cadenhillis/nixie-tube-clock/README.md

# nixie-tube-clock

custom high-voltage boost power supply and nessesary drivers to control IN-12A and IN13 nixies with an adafruit itsybitsy nRF32
