cadenhillis/nixie-tube-clock/nixie-tube-clock-hw/bargraph.jpg

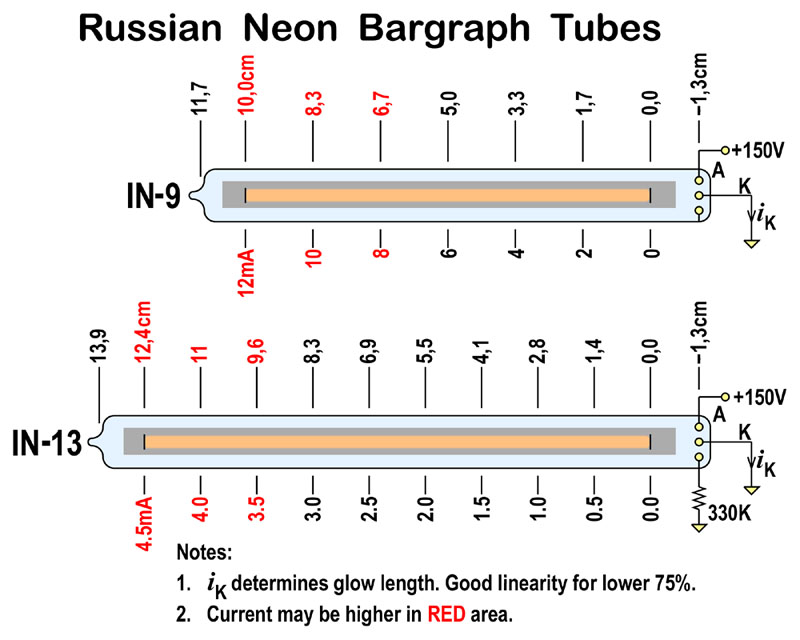
nixie-tube-clock-hw/bargraph.jpg
