cadenhillis/nixie-tube-clock/nixie-tube-clock-hw/fab/nixie-tube-clock digikey.xlsx

nixie-tube-clock
Qty | Reference(s) | P/n
1 | C1 | 63YXJ47M6.3X11
1 | C2 | CL21A225KAFNNNG
1 | C3 | 08053C104KAT2A
1 | C4 | CL21B471KCANNNC
4 | C5, C6, C7, C8 | UPJ2E4R7MPD1TD
1 | C9 | C0805C103J5RAC7800
1 | C10 | CL21B105KAFNNNE
6 | C11, C12, C23, C24, C25, C26 | CL21A106KAYNNNG
2 | C13, C14 | 35ML10MEFCT54X7
8 | C15, C16, C17, C18, C19, C20, C21, C22 | CL21B104KBCNNNC
1 | D1 | SK3200B-LTP
1 | D2 | FDLL4148-D87Z
1 | D3 | BZV55-C3V3,115
2 | D4, D8 | LO R976-PS-1
2 | D5, D6 | NTE30055
1 | D7 | LS R976-NR-1
4 |  | HPH1-A-12-UA
1 | J1 | PJ-036AH-SMT-TR
4 | J2, J3, J4, J5 | LPPB121NFSC-RC
1 | L1 | PM2110-102K-RC
1 | Q1 | FQD16N25CTM
1 | Q2 | PMBT3906,235
44 | Q3, Q4, Q5, Q6, Q7, Q8, Q9, Q10, Q11, Q12, Q13, Q14, Q15, Q16, Q17, Q18, Q19, Q20, Q21, Q22, Q23, Q24, Q25, Q26, Q27, Q28, Q29, Q30, Q31, Q32, Q33, Q34, Q35, Q36, Q37, Q38, Q39, Q40, Q41, Q42, Q43, Q44, Q45, Q46 | MMSTA42-7-F
4 | Q47, Q48, Q49, Q50 | FZT857TA
1 | R1 | ERJ-6DQJR30V
1 | R2 | RNCF0805DTE240R
1 | R3 | RC0805JR-071ML
1 | R4 | KTR10EZPF3004
1 | R5
1 | R6 | RNCP0805FTD20K0
1 | R7 | RC0805FR-071K69L
1 | R8 | RNCP0805FTD24K9
3 | R9, R11, R32 | RNCP0805FTD10K0
6 | R10, R27, R28, R29, R30, R31 | CRG0805F1K2
13 | R12, R13, R14, R15, R16, R17, R18, R19, R20, R21, R22, R23, R24 | RC0805JR-070RL
2 | R25, R26 | CRGCQ0805F220R
40 | R33, R34, R35, R37, R38, R39, R40, R41, R42, R43, R44, R45, R46, R48, R49, R50, R51, R52, R53, R54, R55, R56, R57, R59, R60, R61, R62, R63, R64, R65, R66, R67, R68, R70, R71, R72, R73, R74, R75, R76 | CRGCQ0805F22K
4 | R36, R47, R58, R69 | HRG3216P-2202-D-T1
4 | R77, R81, R85, R89 | CRGCQ0805J330R
4 | R78, R82, R86, R90 | CRG0805F4K7
4 | R79, R83, R87, R91 | ERJ-P6WF3303V
4 | R80, R84, R88, R92 | CRGCQ0805F560R
1 | TH1 | NCP21XV103J03RA
1 | U1 | MC34063AD
1 | U2 | AS321KTR-G1
1 | U4 | NCP1117IDT50T4G
8 | U5, U6, U7, U8, U9, U10, U11, U12 | 74HC594D,118
1 | PS1 | VEL24US120-US-JA
2 | Itsy bitsy sockets | CES-114-01-T-S
