cadenhillis/nixie-tube-clock/nixie-tube-clock-hw/nixie_daughter/nixie_daughter.step

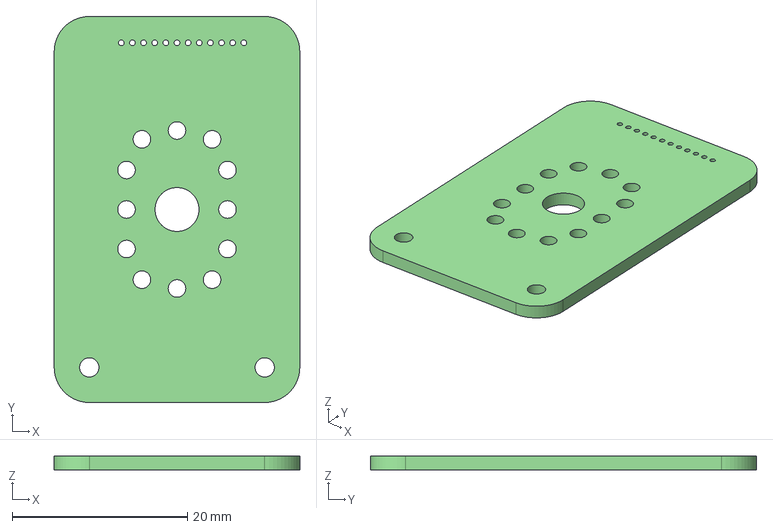
[picture p2: CAD file, 2022-02-12]
nixie-tube-clock-hw/nixie_daughter/nixie_daughter.step
28.0 x 44.0 x 1.60 mm
