cadenhillis/nixie-tube-clock/nixie-tube-clock-hw/parts/front_panel.dxf

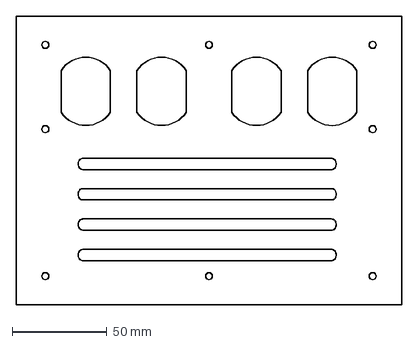
[picture p3: CAD file, 2022-02-14]
nixie-tube-clock-hw/parts/front_panel.dxf
203.2 x 152.4 mm
