cadenhillis/nixie-tube-clock/nixie-tube-clock-hw/parts/in-13_clamp.step

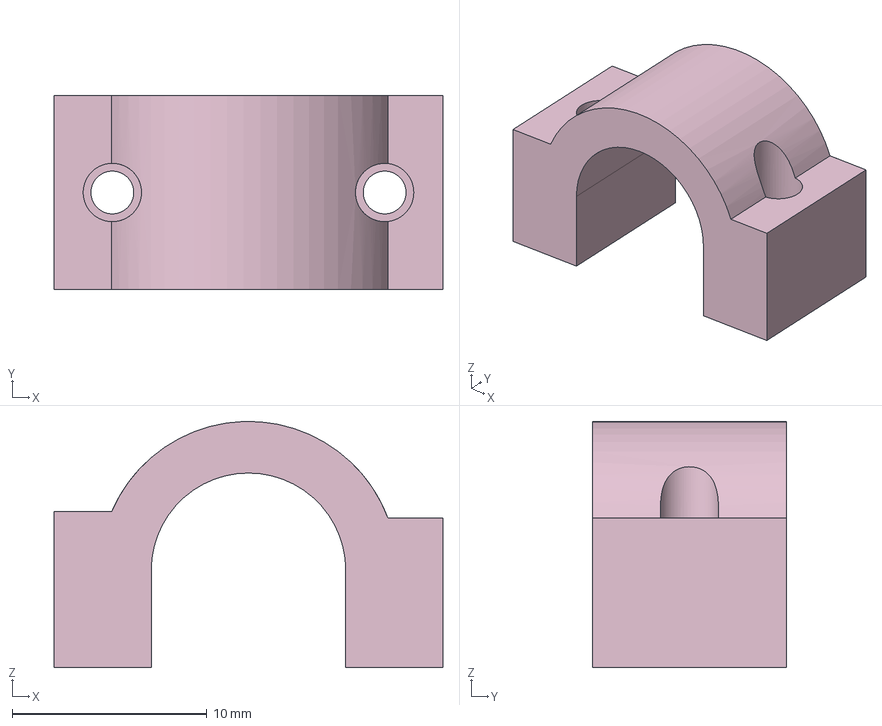
[picture p5: CAD file, 2022-02-14]
nixie-tube-clock-hw/parts/in-13_clamp.step
20.0 x 10.0 x 12.7 mm
