cadenhillis/nixie-tube-clock/(list of files, cad)

Other CAD files:
nixie-tube-clock-hw/parts/in-13_clamp.FCStd
