cadenhillis/nixie-tube-clock/nixie-tube-clock-hw/nixie-tube-clock.kicad_pcb

## KiCad design nixie-tube-clock-hw/nixie-tube-clock.kicad_pcb (2022-02-12)

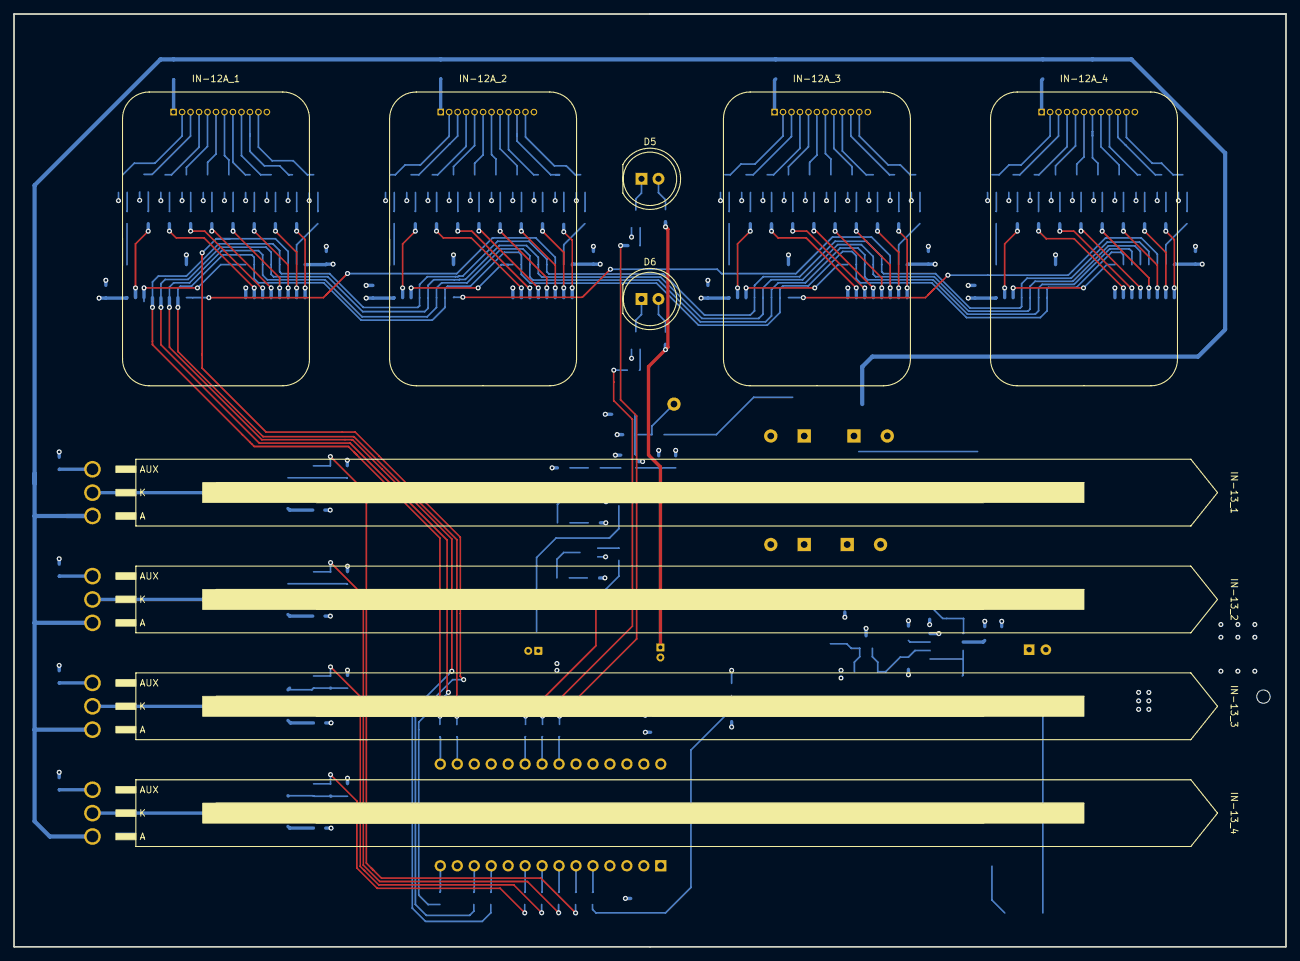
[picture p6: board nixie-tube-clock.kicad_pcb from above]

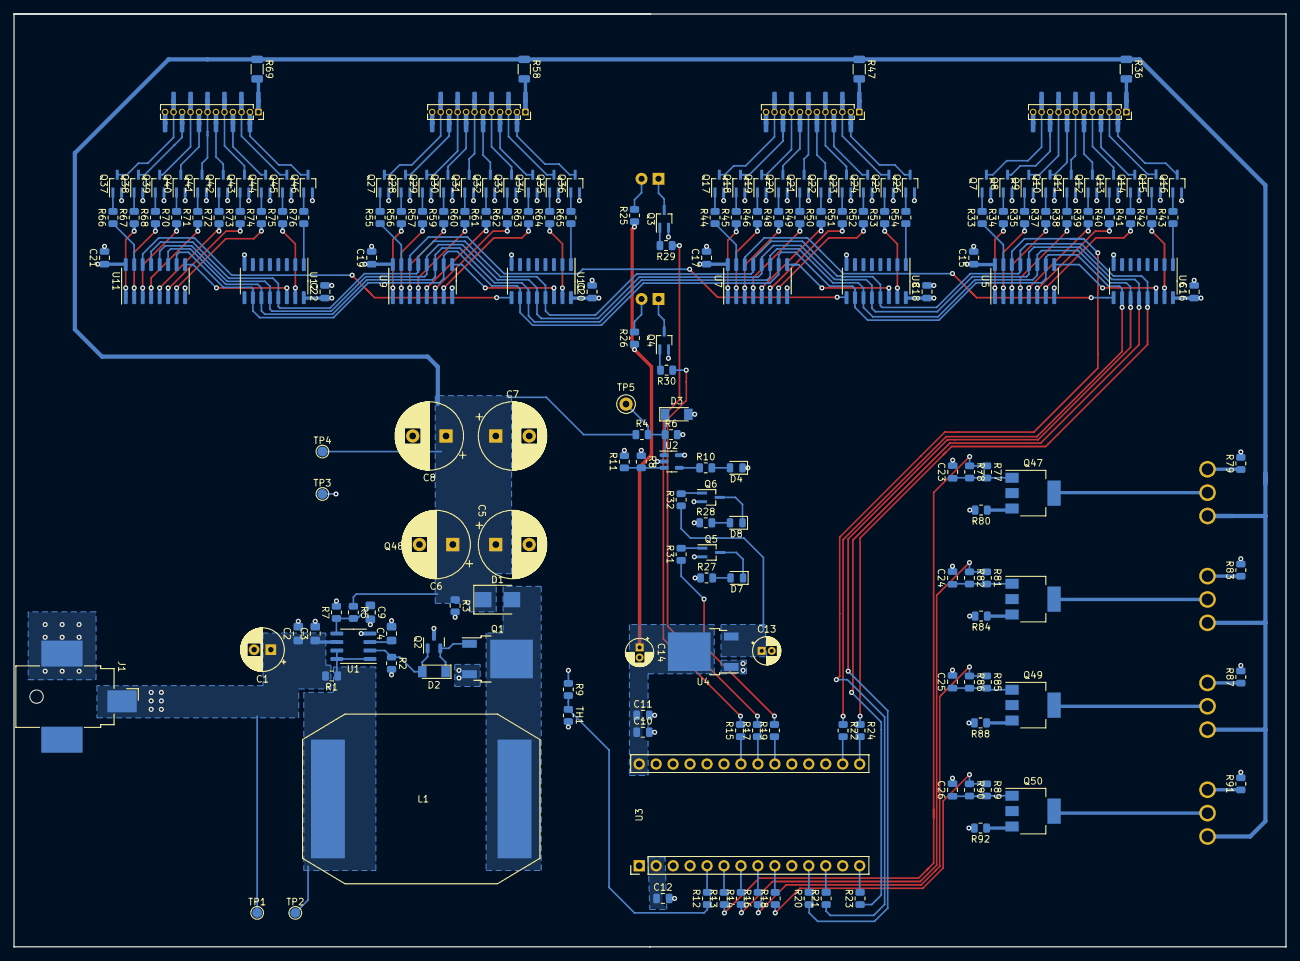
[picture p7: board nixie-tube-clock.kicad_pcb from below]

Board: 4 copper layers, 190.5 x 139.7 mm, 204 parts (194 on the bottom side), 200 nets.

Parts:
C1: 47uF; CP_Radial_D6.3mm_P2.50mm
C2: 2.2uF; C_0805_2012Metric_Pad1.18x1.45mm_HandSolder
C3: 0.1uF; C_0805_2012Metric_Pad1.18x1.45mm_HandSolder
C4: 470pF; C_0805_2012Metric_Pad1.18x1.45mm_HandSolder
C5, C6, C7, C8: 4.7uF; CP_Radial_D10.0mm_P5.00mm
C9: 10nF; C_0805_2012Metric_Pad1.18x1.45mm_HandSolder
C10: 1uF; C_0805_2012Metric
C11, C12, C23, C24, C25, C26: 10uF; C_0805_2012Metric
C13, C14: 10uF; CP_Radial_D4.0mm_P1.50mm
C15, C16, C17, C18, C19, C20, C21, C22: 0.1uF; C_0805_2012Metric
D1: SK3200B-LTP; D_SMB
D2: FDLL4148-D87Z; D_MiniMELF
D3: BZV55-C3V3,115; D_MiniMELF
D4, D8: ORANGE; D_0805_2012Metric
D5, D6: ORANGE; LED_D8.0mm
D7: RED; D_0805_2012Metric
IN-12A_1, IN-12A_2, IN-12A_3, IN-12A_4: IN-12A DAUGHTER; nixie_daughter
IN-13_1, IN-13_2, IN-13_3, IN-13_4: IN13; IN-13
J1: PJ-036AH-SMT-TR; BarrelJack_CUI_PJ-036AH-SMT_Horizontal
L1: 1mH; PM2120
Q1: FQD16N25CTM; TO-252-2
Q2: PMBT3906,235; SOT-23
Q3, Q4, Q5, Q6, Q7, Q8, Q9, Q10, Q11, Q12, Q13, Q14, Q15, Q16, Q17, Q18, Q19, Q20, Q21, Q22, Q23, Q24, Q25, Q26, Q27, Q28, Q29, Q30, Q31, Q32, Q33, Q34, Q35, Q36, Q37, Q38, Q39, Q40, Q41, Q42, Q43, Q44, Q45, Q46: MMSTA42-7-F; SOT-323_SC-70_Handsoldering
Q47, Q48, Q49, Q50: FZT857TA; SOT-223-3_TabPin2
R1: 300mR; R_0805_2012Metric
R2: 240; R_0805_2012Metric
R3: 1M; R_0805_2012Metric
R4: 3Meg; R_0805_2012Metric
R5: 200k; R_0805_2012Metric
R6: 20k; R_0805_2012Metric
R7: 1.68k; R_0805_2012Metric
R8: 25k; R_0805_2012Metric
R9, R11: 10k; R_0805_2012Metric
R10, R27, R28: 1.2k; R_0805_2012Metric
R12, R13, R14, R15, R16, R17, R18, R19, R20, R21, R22, R23, R24: 0; R_0805_2012Metric
R25, R26: 220; R_0805_2012Metric
R29, R30, R31: 1.2K; R_0805_2012Metric
R32: 10K; R_0805_2012Metric
R33, R34, R35, R37, R38, R39, R40, R41, R42, R43, R44, R45, R46, R48, R49, R50, R51, R52, R53, R54, R55, R56, R57, R59, R60, R61, R62, R63, R64, R65, R66, R67, R68, R70, R71, R72, R73, R74, R75, R76: 22k; R_0805_2012Metric
R36, R47, R58, R69: R_US; R_1206_3216Metric
R77, R81, R85, R89: 330; R_0805_2012Metric
R78, R82, R86, R90: 4.7k; R_0805_2012Metric
R79, R83, R87, R91: 330k; R_0805_2012Metric
R80, R84, R88, R92: 560; R_0805_2012Metric
TH1: 10k; R_0805_2012Metric
TP1, TP2, TP3, TP4: TestPoint; TestPoint_Pad_D1.5mm
TP5: TestPoint; TestPoint_Keystone_5000-5004_Miniature
U1: MC34063AD; SOIC-8_3.9x4.9mm_P1.27mm
U2: AS321KTR-G1; SOT-23-5
U3: ItsyBitsy_M0_Express; ItsyBitsy
U4: NCP1117IDT50T4G; TO-252-2
U5, U6, U7, U8, U9, U10, U11, U12: 74HC594D,118; SOIC-16_3.9x9.9mm_P1.27mm

Connections:
+3V3: C12.1, C15.1, C16.1, C17.1, C18.1, C19.1, C20.1, C21.1, C22.1, R8.1, R9.1, R27.1, R28.1, U2.5 (V+), U3.2 (3V3), U5.16 (VCC), U6.16 (VCC), U7.16 (VCC), U8.16 (VCC), U9.16 (VCC), U10.16 (VCC), U11.16 (VCC), U12.16 (VCC)
+5V: C10.1, C11.1, C14.1, R25.1, R26.1, U3.28 (BAT), U4.2 (VO)
+12V: C1.1, C2.1, C3.1, C13.1, J1.1, R1.2, R32.1, TP1.1, U1.6 (Vin), U4.3 (VI)
/150V_VA/1v_LED: D3.1 (K), R4.2, R6.1, TP5.1, U2.1 (+)
/COLON_1: R15.2, R29.1
/COLON_2: R17.2, R30.1
/D1/B0: R43.1, U6.1 (Q1)
/D1/B1: R33.1, U5.15 (Q0)
/D1/B2: R34.1, U5.1 (Q1)
/D1/B3: R35.1, U5.2 (Q2)
/D1/B4: R37.1, U5.3 (Q3)
/D1/B5: R38.1, U5.4 (Q4)
/D1/B6: R39.1, U5.5 (Q5)
/D1/B7: R40.1, U5.6 (Q6)
/D1/B8: R41.1, U5.7 (Q7)
/D1/B9: R42.1, U6.15 (Q0)
/D1/DOUT: U6.9 (Q7S), U7.14 (DS)
/D1/K0: IN-12A_1.2 (K_0), Q16.3 (C)
/D1/K1: IN-12A_1.11 (K_1), Q7.3 (C)
/D1/K2: IN-12A_1.10 (K_2), Q8.3 (C)
/D1/K3: IN-12A_1.9 (K_3), Q9.3 (C)
/D1/K4: IN-12A_1.8 (K_4), Q10.3 (C)
/D1/K5: IN-12A_1.7 (K_5), Q11.3 (C)
/D1/K6: IN-12A_1.6 (K_6), Q12.3 (C)
/D1/K7: IN-12A_1.5 (K_7), Q13.3 (C)
/D1/K8: IN-12A_1.4 (K_8), Q14.3 (C)
/D1/K9: IN-12A_1.3 (K_9), Q15.3 (C)
/D2/B0: R54.1, U8.1 (Q1)
/D2/B1: R44.1, U7.15 (Q0)
/D2/B2: R45.1, U7.1 (Q1)
/D2/B3: R46.1, U7.2 (Q2)
/D2/B4: R48.1, U7.3 (Q3)
/D2/B5: R49.1, U7.4 (Q4)
/D2/B6: R50.1, U7.5 (Q5)
/D2/B7: R51.1, U7.6 (Q6)
/D2/B8: R52.1, U7.7 (Q7)
/D2/B9: R53.1, U8.15 (Q0)
/D2/DOUT: U8.9 (Q7S), U9.14 (DS)
/D2/K0: IN-12A_2.2 (K_0), Q26.3 (C)
/D2/K1: IN-12A_2.11 (K_1), Q17.3 (C)
/D2/K2: IN-12A_2.10 (K_2), Q18.3 (C)
/D2/K3: IN-12A_2.9 (K_3), Q19.3 (C)
/D2/K4: IN-12A_2.8 (K_4), Q20.3 (C)
/D2/K5: IN-12A_2.7 (K_5), Q21.3 (C)
/D2/K6: IN-12A_2.6 (K_6), Q22.3 (C)
/D2/K7: IN-12A_2.5 (K_7), Q23.3 (C)
/D2/K8: IN-12A_2.4 (K_8), Q24.3 (C)
/D2/K9: IN-12A_2.3 (K_9), Q25.3 (C)
/D3/B0: R65.1, U10.1 (Q1)
/D3/B1: R55.1, U9.15 (Q0)
/D3/B2: R56.1, U9.1 (Q1)
/D3/B3: R57.1, U9.2 (Q2)
/D3/B4: R59.1, U9.3 (Q3)
/D3/B5: R60.1, U9.4 (Q4)
/D3/B6: R61.1, U9.5 (Q5)
/D3/B7: R62.1, U9.6 (Q6)
/D3/B8: R63.1, U9.7 (Q7)
/D3/B9: R64.1, U10.15 (Q0)
/D3/DOUT: U10.9 (Q7S), U11.14 (DS)
/D3/K0: IN-12A_3.2 (K_0), Q36.3 (C)
/D3/K1: IN-12A_3.11 (K_1), Q27.3 (C)
/D3/K2: IN-12A_3.10 (K_2), Q28.3 (C)
/D3/K3: IN-12A_3.9 (K_3), Q29.3 (C)
/D3/K4: IN-12A_3.8 (K_4), Q30.3 (C)
/D3/K5: IN-12A_3.7 (K_5), Q31.3 (C)
/D3/K6: IN-12A_3.6 (K_6), Q32.3 (C)
/D3/K7: IN-12A_3.5 (K_7), Q33.3 (C)
/D3/K8: IN-12A_3.4 (K_8), Q34.3 (C)
/D3/K9: IN-12A_3.3 (K_9), Q35.3 (C)
/D4/B0: R76.1, U12.1 (Q1)
/D4/B1: R66.1, U11.15 (Q0)
/D4/B2: R67.1, U11.1 (Q1)
/D4/B3: R68.1, U11.2 (Q2)
/D4/B4: R70.1, U11.3 (Q3)
/D4/B5: R71.1, U11.4 (Q4)
/D4/B6: R72.1, U11.5 (Q5)
/D4/B7: R73.1, U11.6 (Q6)
/D4/B8: R74.1, U11.7 (Q7)
/D4/B9: R75.1, U12.15 (Q0)
/D4/K0: IN-12A_4.2 (K_0), Q46.3 (C)
/D4/K1: IN-12A_4.11 (K_1), Q37.3 (C)
/D4/K2: IN-12A_4.10 (K_2), Q38.3 (C)
/D4/K3: IN-12A_4.9 (K_3), Q39.3 (C)
/D4/K4: IN-12A_4.8 (K_4), Q40.3 (C)
/D4/K5: IN-12A_4.7 (K_5), Q41.3 (C)
/D4/K6: IN-12A_4.6 (K_6), Q42.3 (C)
/D4/K7: IN-12A_4.5 (K_7), Q43.3 (C)
/D4/K8: IN-12A_4.4 (K_8), Q44.3 (C)
/D4/K9: IN-12A_4.3 (K_9), Q45.3 (C)
/DAY_PWM: R13.1, R77.1, R78.1
/MONTH_PWM: R16.1, R85.1, R86.1
/MOSI: R21.1, U5.14 (DS)
/SCK: R20.1, U5.11 (SHCP), U6.11 (SHCP), U7.11 (SHCP), U8.11 (SHCP), U9.11 (SHCP), U10.11 (SHCP), U11.11 (SHCP), U12.11 (SHCP)
/STORE: R23.1, U5.12 (STCP), U6.12 (STCP), U7.12 (STCP), U8.12 (STCP), U9.12 (STCP), U10.12 (STCP), U11.12 (STCP), U12.12 (STCP)
/TEMP: R9.2, R12.1, TH1.1
/TEMP_LED: R19.2, R31.1
/WEEK_PWM: R14.1, R81.1, R82.1
/YEAR_PWM: R18.1, R89.1, R90.1
/~CLR_SHIFT: R22.1, U5.10 (~SHR), U6.10 (~SHR), U7.10 (~SHR), U8.10 (~SHR), U9.10 (~SHR), U10.10 (~SHR), U11.10 (~SHR), U12.10 (~SHR)
/~CLR_STORE: R24.1, U5.13 (~STR), U6.13 (~STR), U7.13 (~STR), U8.13 (~STR), U9.13 (~STR), U10.13 (~STR), U11.13 (~STR), U12.13 (~STR)
GND: C1.2, C2.2, C3.2, C4.2, C5.2, C6.2, C7.2, C8.2, C9.2, C10.2, C11.2, C12.2, C13.2, C14.2, C15.2, C16.2, C17.2, C18.2, C19.2, C20.2, C21.2, C22.2, C23.2, C24.2, C25.2, C26.2, D3.2 (A), D4.1 (K), J1.2, Q1.3 (S), Q2.3 (C), Q3.2 (E), Q4.2 (E), Q5.2 (E), Q6.2 (E), Q7.2 (E), Q8.2 (E), Q9.2 (E), Q10.2 (E), Q11.2 (E), Q12.2 (E), Q13.2 (E), Q14.2 (E), Q15.2 (E), Q16.2 (E), Q17.2 (E), Q18.2 (E), Q19.2 (E), Q20.2 (E), Q21.2 (E), Q22.2 (E), Q23.2 (E), Q24.2 (E), Q25.2 (E), Q26.2 (E), Q27.2 (E), Q28.2 (E), Q29.2 (E), Q30.2 (E), Q31.2 (E), Q32.2 (E), Q33.2 (E), Q34.2 (E), Q35.2 (E), Q36.2 (E), Q37.2 (E), Q38.2 (E), Q39.2 (E), Q40.2 (E), Q41.2 (E), Q42.2 (E), Q43.2 (E), Q44.2 (E), Q45.2 (E), Q46.2 (E), R2.2, R3.2, R6.2, R7.2, R11.2, R79.2, R80.2, R83.2, R84.2, R87.2, R88.2, R91.2, R92.2, TH1.2, TP3.1, U1.4 (GND), U2.2 (V-), U3.27 (G), U4.1 (ADJ), U5.8 (GND), U6.8 (GND), U7.8 (GND), U8.8 (GND), U9.8 (GND), U10.8 (GND), U11.8 (GND), U12.8 (GND)
unnamed: C4.1, U1.3 (TC)
unnamed: C9.1, R5.2, R7.1, U1.5 (Vfb)
unnamed: C23.1, Q47.1 (B), R77.2, R78.2
unnamed: C24.1, Q48.1 (B), R81.2, R82.2
unnamed: C25.1, Q49.1 (B), R85.2, R86.2
unnamed: C26.1, Q50.1 (B), R89.2, R90.2
unnamed: D1.2 (A), L1.2, Q1.2 (D)
unnamed: D2.1 (K), Q1.1 (G), Q2.2 (E)
unnamed: D2.2 (A), Q2.1 (B), R2.1, U1.2 (SwE)
unnamed: D4.2 (A), R10.2
unnamed: D5.1 (K), Q3.3 (C)
unnamed: D5.2 (A), R25.2
unnamed: D6.1 (K), Q4.3 (C)
unnamed: D6.2 (A), R26.2
unnamed: D7.1 (K), Q5.3 (C)
unnamed: D7.2 (A), R27.2
unnamed: D8.1 (K), Q6.3 (C)
unnamed: D8.2 (A), R28.2
unnamed: IN-12A_1.1 (A), R36.2
unnamed: IN-12A_2.1 (A), R47.2
unnamed: IN-12A_3.1 (A), R58.2
unnamed: IN-12A_4.1 (A), R69.2
unnamed: IN-13_1.1, R79.1
unnamed: IN-13_1.2, Q47.2 (C)
unnamed: IN-13_2.1, R83.1
unnamed: IN-13_2.2, Q48.2 (C)
unnamed: IN-13_3.1, R87.1
unnamed: IN-13_3.2, Q49.2 (C)
unnamed: IN-13_4.1, R91.1
unnamed: IN-13_4.2, Q50.2 (C)
unnamed: L1.1, R1.1, TP2.1, U1.1 (SwC), U1.7 (Ipk), U1.8 (DC)
unnamed: Q3.1 (B), R29.2
unnamed: Q4.1 (B), R30.2
unnamed: Q5.1 (B), R31.2
unnamed: Q6.1 (B), R32.2
unnamed: Q7.1 (B), R33.2
unnamed: Q8.1 (B), R34.2
unnamed: Q9.1 (B), R35.2
unnamed: Q10.1 (B), R37.2
unnamed: Q11.1 (B), R38.2
unnamed: Q12.1 (B), R39.2
unnamed: Q13.1 (B), R40.2
unnamed: Q14.1 (B), R41.2
unnamed: Q15.1 (B), R42.2
unnamed: Q16.1 (B), R43.2
unnamed: Q17.1 (B), R44.2
unnamed: Q18.1 (B), R45.2
unnamed: Q19.1 (B), R46.2
unnamed: Q20.1 (B), R48.2
unnamed: Q21.1 (B), R49.2
unnamed: Q22.1 (B), R50.2
unnamed: Q23.1 (B), R51.2
unnamed: Q24.1 (B), R52.2
unnamed: Q25.1 (B), R53.2
unnamed: Q26.1 (B), R54.2
unnamed: Q27.1 (B), R55.2
unnamed: Q28.1 (B), R56.2
unnamed: Q29.1 (B), R57.2
unnamed: Q30.1 (B), R59.2
unnamed: Q31.1 (B), R60.2
unnamed: Q32.1 (B), R61.2
unnamed: Q33.1 (B), R62.2
unnamed: Q34.1 (B), R63.2
unnamed: Q35.1 (B), R64.2
unnamed: Q36.1 (B), R65.2
unnamed: Q37.1 (B), R66.2
unnamed: Q38.1 (B), R67.2
unnamed: Q39.1 (B), R68.2
unnamed: Q40.1 (B), R70.2
unnamed: Q41.1 (B), R71.2
unnamed: Q42.1 (B), R72.2
unnamed: Q43.1 (B), R73.2
unnamed: Q44.1 (B), R74.2
unnamed: Q45.1 (B), R75.2
unnamed: Q46.1 (B), R76.2
unnamed: Q47.3 (E), R80.1
unnamed: Q48.3 (E), R84.1
unnamed: Q49.3 (E), R88.1
unnamed: Q50.3 (E), R92.1
unnamed: R10.1, U2.4
unnamed: R8.2, R11.1, U2.3 (-)
unnamed: R12.2, U3.5 (A0)
unnamed: R13.2, U3.6 (A1)
unnamed: R14.2, U3.7 (A2)
unnamed: R15.1, U3.22 (10)
unnamed: R16.2, U3.8 (A3)
unnamed: R17.1, U3.21 (9)
unnamed: R18.2, U3.9 (A4)
unnamed: R19.1, U3.20 (7)
unnamed: R20.2, U3.11 (SCK)
unnamed: R21.2, U3.12 (MO)
unnamed: R22.2, U3.16 (1_TX)
unnamed: R23.2, U3.14 (D2)
unnamed: R24.2, U3.15 (0_RX)
unnamed: U5.9 (Q7S), U6.14 (DS)
unnamed: U7.9 (Q7S), U8.14 (DS)
unnamed: U9.9 (Q7S), U10.14 (DS)
unnamed: U11.9 (Q7S), U12.14 (DS)
VAA: C5.1, C6.1, C7.1, C8.1, D1.1 (K), IN-13_1.3, IN-13_2.3, IN-13_3.3, IN-13_4.3, R3.1, R4.1, R5.1, R36.1, R47.1, R58.1, R69.1, TP4.1
