cadenhillis/nixie-tube-clock/(commit log)

2022-02-12 layout and routing
    [12_150_Boost.kicad_sch, IN-13-Driver.kicad_sch, IN12A-Driver.kicad_sch, nixie-tube-clock.kicad_pcb, nixie_daughter.kicad_pcb, nixie_daughter.kicad_sch, nixie_daughter.step]
2022-02-14 fab stuff
    [IN-13-Driver.kicad_sch, front_panel.dxf, in-13_clamp.FCStd, in-13_clamp.step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]
2022-03-13 minor board / part changes
    [12_150_Boost.kicad_sch, IN-13-Driver.kicad_sch, nixie-tube-clock digikey.xlsx, nixie-tube-clock.kicad_sch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]
2022-04-25 el fin
